liqi-Chang/SCVS/錡想X三重專題式遙控車電路設計圖說_END.pdf

# 錡想 X 三重 遙控車電路設計圖說

目錄
圖號 | 圖名
E-01 | 材料表
E-02 | 設備放置圖
E-03 | 繼電器板配置圖
E-04 | 系統單線圖
E-05 | 遙控器單線圖
------ | 附件

### 設備材料

次項 | 項目

01
02
03
04 | SG 90 Servo 18650 三串電池盒
| ESP 32s 130 馬達
| c1815
05 | srd-03vdc-sl-c
單位 | 數量
個
08 | 雙軸按鍵搖桿模組
09 | 180Ω 1/4w

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
E-01

錡想 X 三重 專題式遙控車

材料表

比例 | 角法 | 專案名稱

設計師
張立錡
| | 圖名

1
5
3*7 CM 單面 PCB板 | 個 | 1

## servo

## 18650電池盒 ESP32

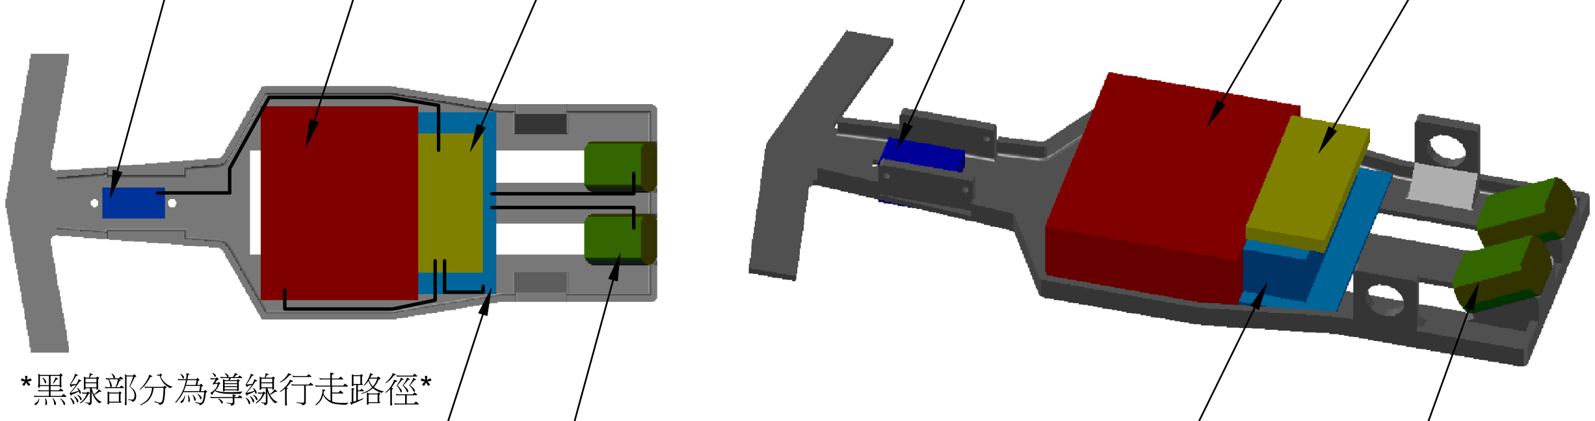
[picture p24: figure]
*黑線部分為導線行走路徑*

## 繼電器板

馬達

12*32*22mm

75*60*20mm

25*54*5mm

30*70*20mm

20*38*15mm

圖號
圖號
設備放置圖 | E-02
比例 | 角法 | 專案名稱

設計師
| | 圖名

2
5

錡想 X 三重 專題式遙控車

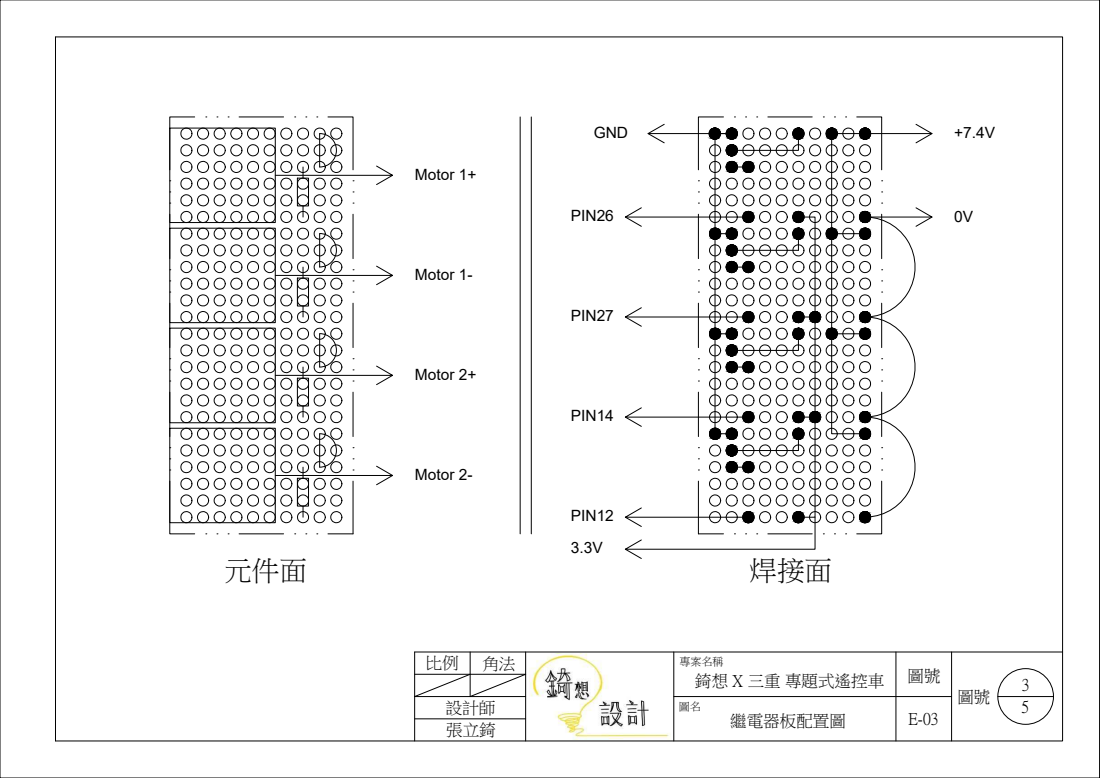
[picture p25: page 4]
元件面; 焊接面; PIN12; PIN14; PIN27; PIN26; GND; Motor 1+; Motor 1-; Motor 2+; Motor 2-; 繼電器板配置圖; 專案名稱; 設計師

錡想 X 三重 專題式遙控車

3.3V 678

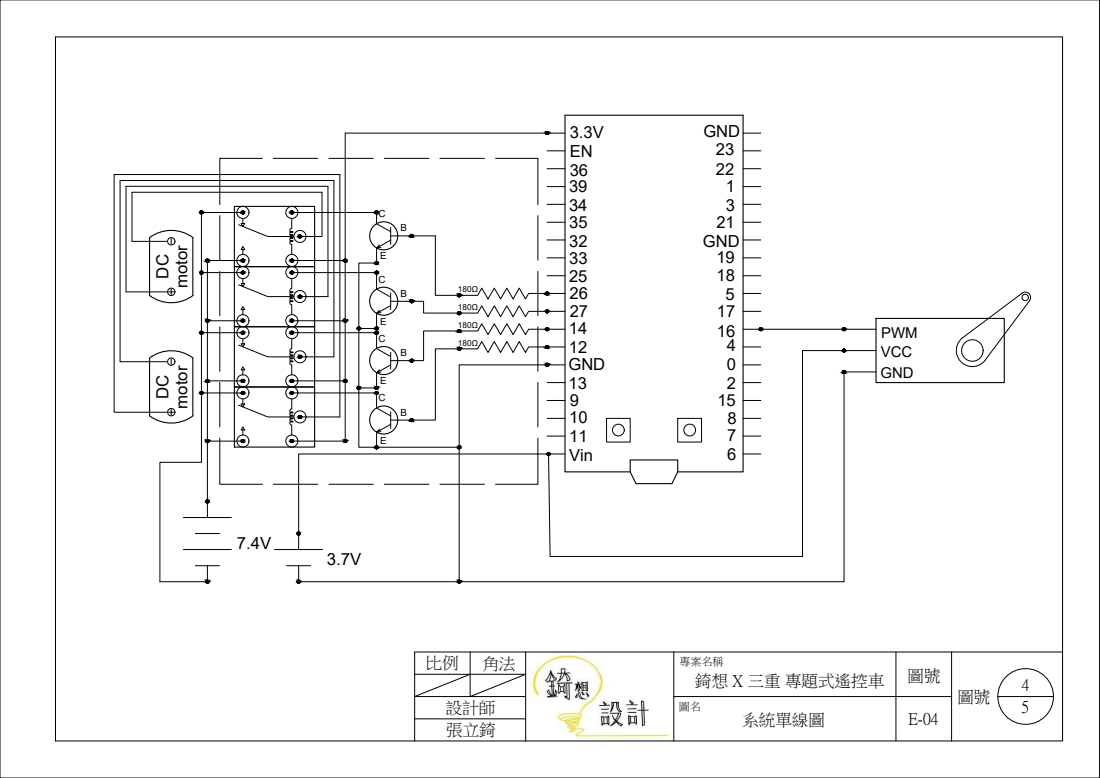
[picture p26: page 5]
Vin; GND; PWM VCC; 系統單線圖; 專案名稱; 設計師

GND DC motor DC motor

錡想 X 三重 專題式遙控車

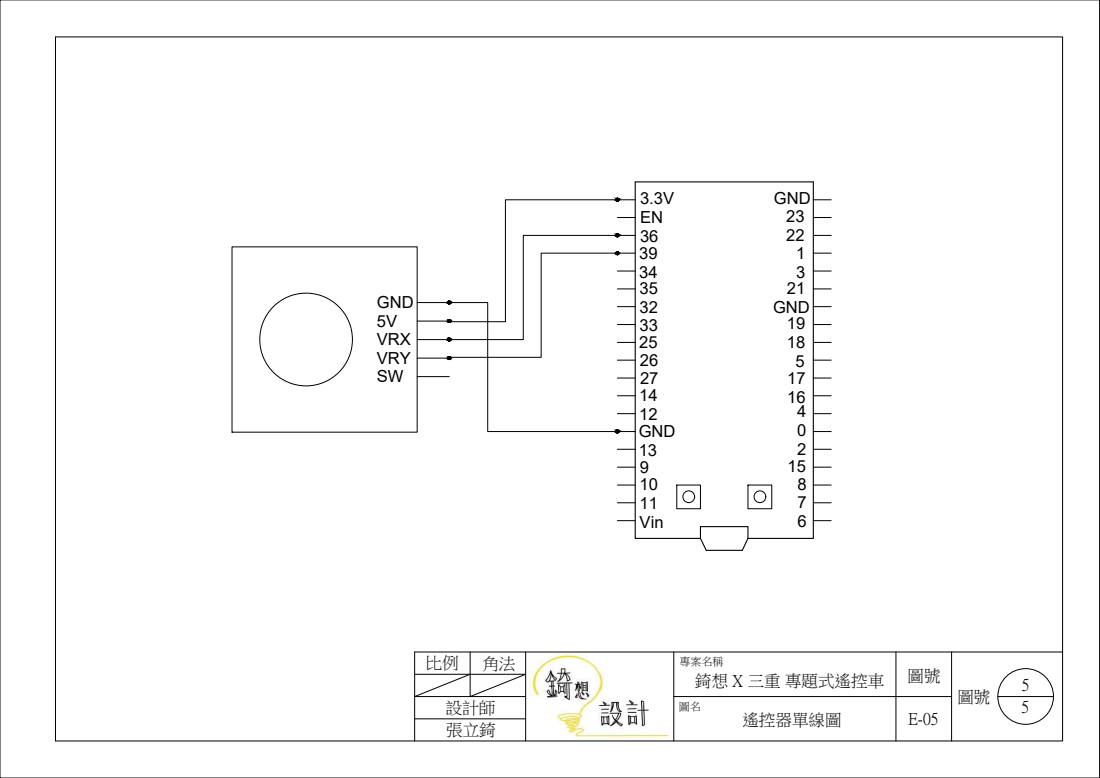
[picture p27: page 6]
Vin; GND; GND 5V VRX VRY SW; 遙控器單線圖; 專案名稱; 設計師

錡想 X 三重 專題式遙控車

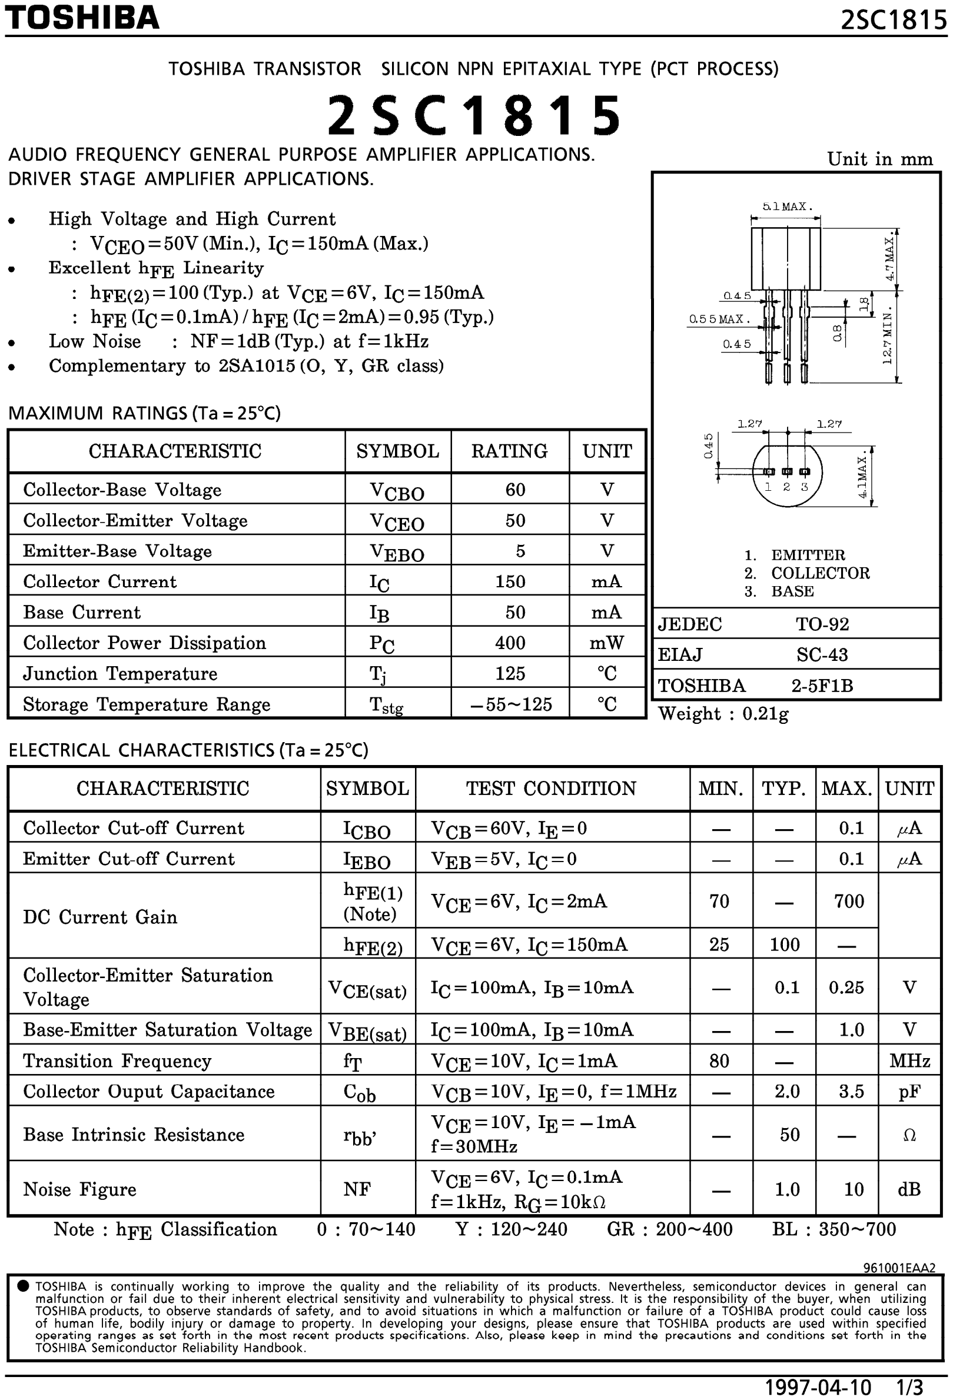
[picture p28: page 7]

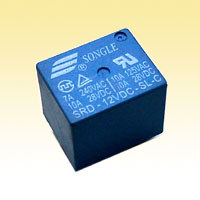
[picture p29: figure]

### 2. APPLICATIONS

- Domestic appliance, office machine, audio, equipment, automobile, etc.
( Remote control TV receiver, monitor display, audio equipment high rushing current use application.)

### 3. ORDERING INFORMATION

SRD | XX VDC | S | L | C
Model of relay | Nominal coil voltage | Structure | Coil sensitivity | Contact form
| 03050609122448VDC | S:Sealed type | L:0.36W SRD | A:1 form A B:1 form B
F:Flux free type | D:0.45W | C:1 form C

### 4. RATING

CCC | FILE NUMBER:CH0052885-2000 7A/240VDC
CCC | FILE NUMBER:CH0036746-99 | 10A/250VDC
UL /CUL | FILE NUMBER: E167996 | 10A/125VAC 28VDC
TUV | FILE NUMBER: R9933789 | 10A/240VAC 28VDC
5. DIMENSION(unit:mm) | DRILLING(unit:mm) | WIRING DIAGRAM
RELAY ISO9002 | -

### 1. MAIN FEATURES

- Switching capacity available by 10A in spite of small size design for highdensity P.C. board mounting technique.
- UL,CUL,TUV recognized.
- Selection of plastic material for high temperature and better chemical solution performance.
- Sealed types available.
- Simple relay magnetic circuit to meet low cost of mass production.

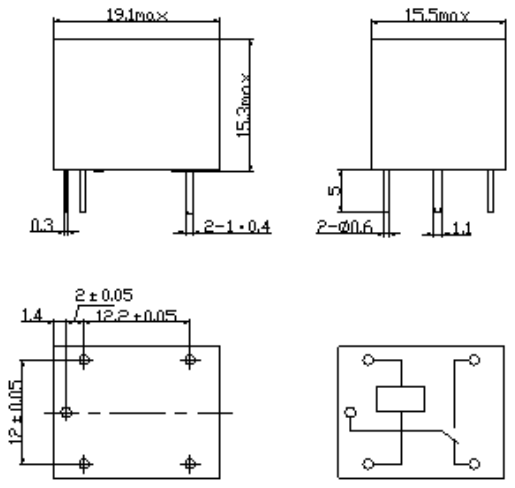
[picture p30: figure]
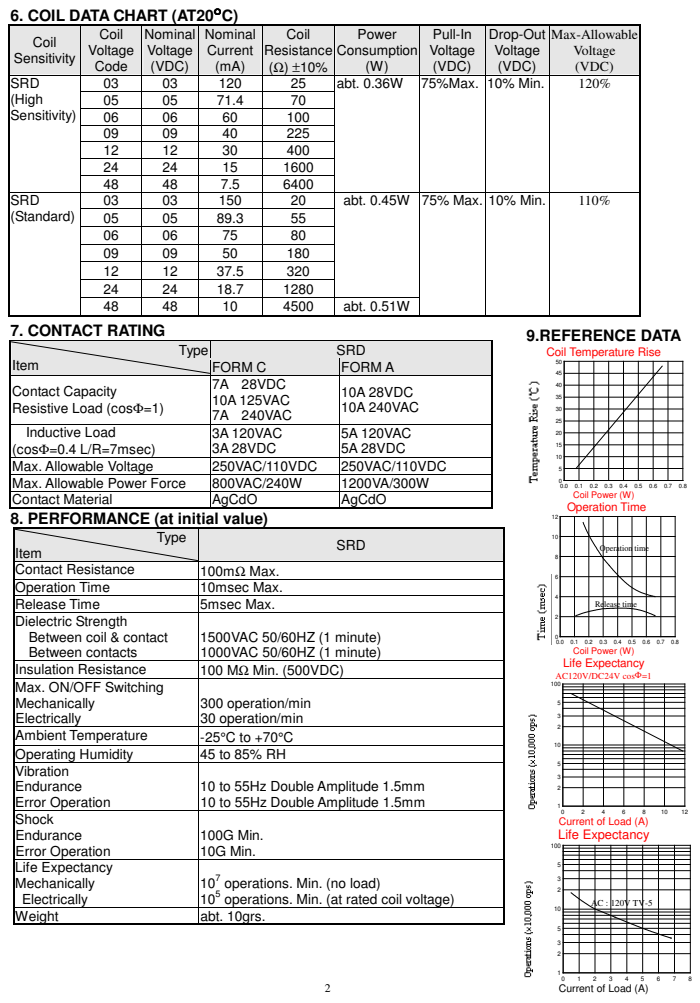
[picture p31: page 9]
7. CONTACT RATING; Release Time; 5msec Max.; 9.REFERENCE DATA Coil Temperature Rise; Coil Power (W) Operation Time; Operation time; Release time; Coil Power (W) Life Expectancy AC120V/DC24V cosΦ=1

6. COIL DATA CHART (AT20

Coil Sensitivity | Coil Voltage Code | Nominal Voltage (VDC) | Nominal Current (mA) | Coil Resistance (Ω) ±10% | Power Consumption (W) | Pull-In Voltage (VDC) | Drop-Out Voltage (VDC) | Max-Allowable Voltage (VDC)

SRD (High Sensitivity) | 03 | 03 | 120 | 25 | abt. 0.36W | 75%Max. | 10% Min. | 120%

05 | 05 | 71.4 | 70
06 | 06 | 60 | 100
09 | 09 | 40 | 225
12 | 12 | 30 | 400
24 | 24 | 15 | 1600
48 | 48 | 7.5 | 6400

SRD (Standard) | 03 | 03 | 150 | 20 | abt. 0.45W | 75% Max. | 10% Min. | 110%

05 | 05 | 89.3 | 55
06 | 06 | 75 | 80
09 | 09 | 50 | 180
12 | 12 | 37.5 | 320
24 | 24 | 18.7 | 1280
48 | 48 | 10 | 4500 | abt. 0.51W

Type Item | SRD
FORM C | FORM A
Contact Capacity Resistive Load (cosΦ=1) | 7A 28VDC 10A 125VAC 7A 240VAC | 10A 28VDC 10A 240VAC

Inductive Load (cosΦ=0.4 L/R=7msec) | 3A 120VAC 3A 28VDC | 5A 120VAC 5A 28VDC

Max. Allowable Voltage | 250VAC/110VDC | 250VAC/110VDC
Max. Allowable Power Force | 800VAC/240W | 1200VA/300W
Contact Material | AgCdO | AgCdO

8. PERFORMANCE (at initial value)

Contact Resistance | 100mΩ Max.
Operation Time | 10msec Max.

Dielectric Strength Between coil & contact Between contacts | 1500VAC 50/60HZ (1 minute) 1000VAC 50/60HZ (1 minute)

Insulation Resistance | 100 MΩ Min. (500VDC)
Max. ON/OFF Switching Mechanically Electrically | 300 operation/min 30 operation/min

Ambient Temperature | -25°C to +70°C
Operating Humidity | 45 to 85% RH
Vibration Endurance Error Operation | 10 to 55Hz Double Amplitude 1.5mm

Current of Load (A)
Life Expectancy

Shock Endurance Error Operation | 100G Min. 10G Min.

Life Expectancy Mechanically Electrically | 7 10 operations. Min. (no load) 10 5 operations. Min. (at rated coil voltage)

Weight | abt. 10grs.
